hotchk155/oneDpong/docs/oneDpong.png

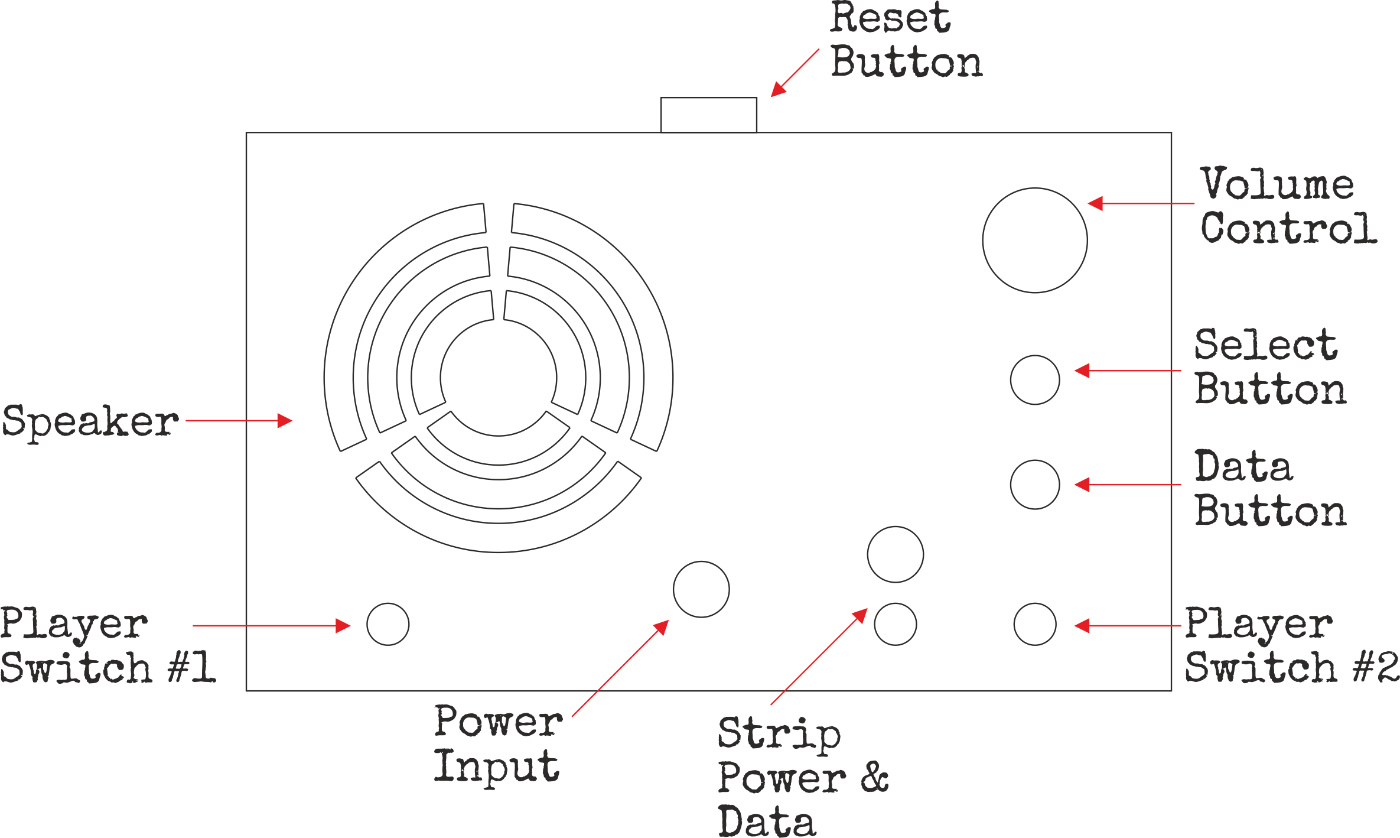
docs/oneDpong.png
