hotchk155/oneDpong/oneDpong.brd

## EAGLE design oneDpong.brd (2025-04-09)

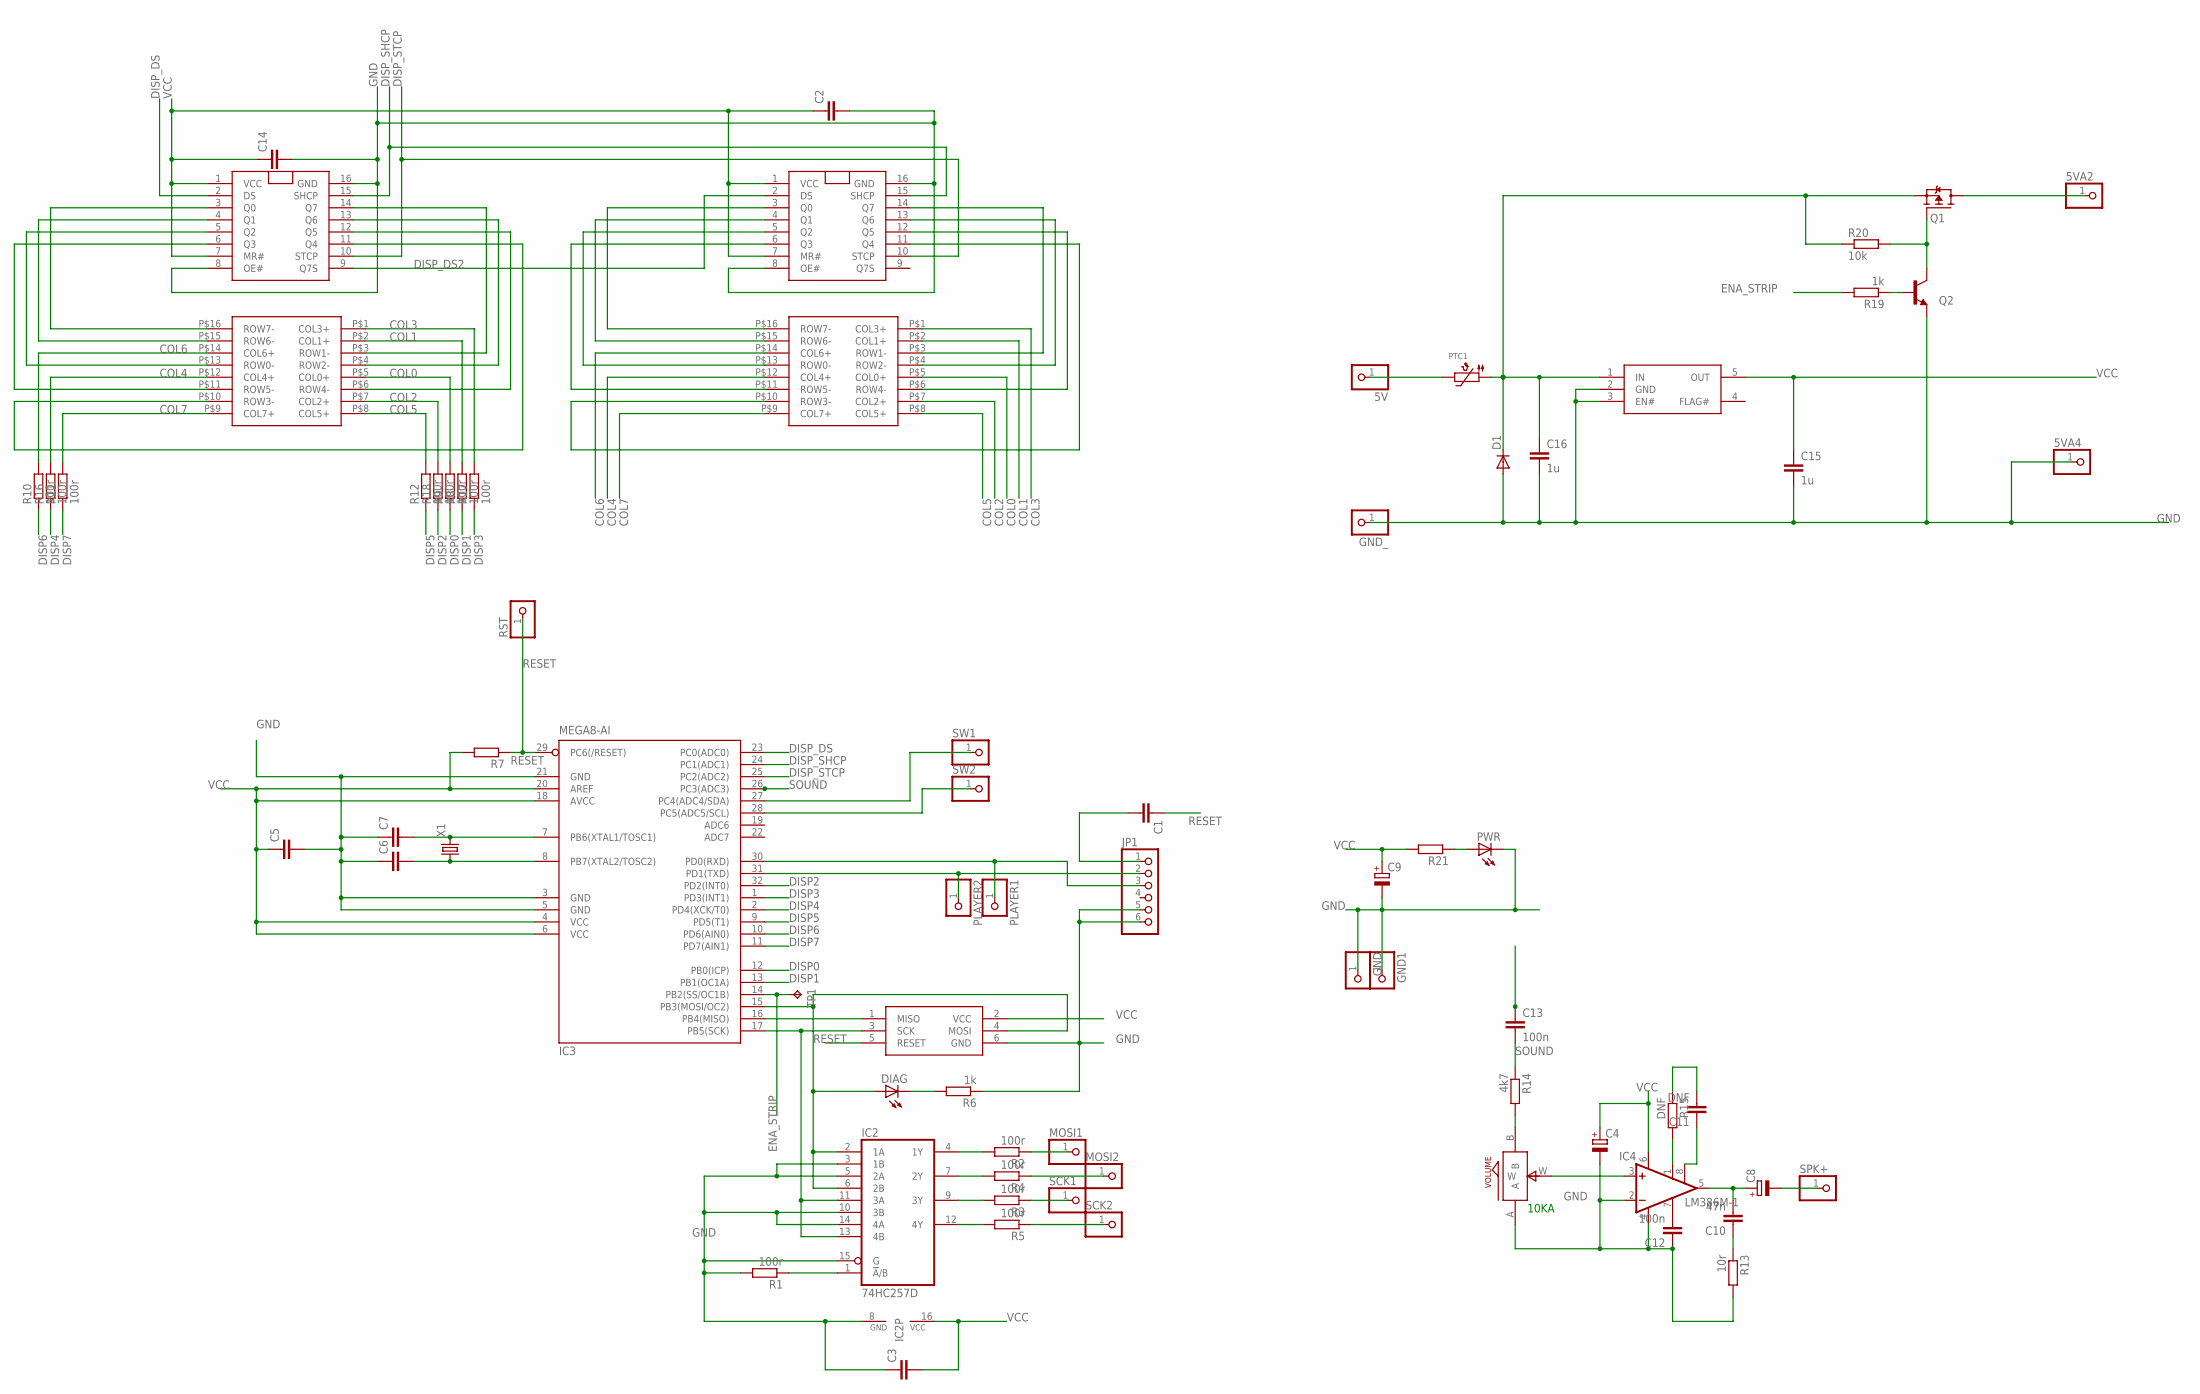
[picture p2: schematic oneDpong.sch]

Parts:
5V, 5VA2, 5VA4: PINHD-1X1; 1X01
C1, C2, C3, C5, C6, C7, C14: C-EUC0805; C0805
C4, C8, C9: CPOL-EUE2.5-6; E2,5-6
C10: 47n; C0805
C11: DNF; C0805
C12, C13: 100n; C0805
C15, C16: 1u; C0805
D1: DIODE-SMC; SMC
DIAG: LED3MM
GND, GND1: PINHD-1X1; 1X01
GND_: PINHD-1X1; 1X01
IC1, IC5: NPIC6C596; SO16
IC2: 74HC257D; SO16
IC3: MEGA8-AI; TQFP32-08
IC4: LM386M-1; SO08
IC6: NCP361SNT1G; SOT23-5
ICSP: TAG_CONN_AVR; TC2030-MCP-NL
JP1: PINHD-1X6; 1X06
MOSI1, MOSI2: PINHD-1X1; 1X01
PLAYER1, PLAYER2: PINHD-1X1; 1X01
PTC1: PTC1812
PWR: LED3MM
Q1: SPD30P06PTO252; TO252
Q2: MMBT3904LT1-NPN-SOT23-BEC; SOT23-BEC
R1, R2, R3, R4, R5, R8, R9, R10, R11, R12, R16, R17, R18: 100r; R0805
R6, R19: 1k; R0805
R7, R21: R-EU_R0805; R0805
R13: 10r; R0805
R14: 4k7; R0805
R15: DNF; R0805
R20: 10k; R0805
RST: PINHD-1X1; 1X01
SCK1, SCK2: PINHD-1X1; 1X01
SPK+: PINHD-1X1; 1X01
SW1, SW2: PINHD-1X1; 1X01
TP1: TPB1,27; B1,27
U$1, U$2: LARGE8X8
VOLUME: ALPS_POT_SMALL; SMALL_ALPS_POT
X1: CRYSTALHC49U-V; HC49U-V

Connections:
COL0: R9.2, U$1.P$5 (COL0+), U$2.P$5 (COL0+)
COL1: R8.2, U$1.P$2 (COL1+), U$2.P$2 (COL1+)
COL2: R18.2, U$1.P$7 (COL2+), U$2.P$7 (COL2+)
COL3: R17.2, U$1.P$1 (COL3+), U$2.P$1 (COL3+)
COL4: R16.2, U$1.P$12 (COL4+), U$2.P$12 (COL4+)
COL5: R12.2, U$1.P$8 (COL5+), U$2.P$8 (COL5+)
COL6: R10.2, U$1.P$14 (COL6+), U$2.P$14 (COL6+)
COL7: R11.2, U$1.P$9 (COL7+), U$2.P$9 (COL7+)
DISP0: IC3.12 (PB0(ICP)), R9.1
DISP1: IC3.13 (PB1(OC1A)), R8.1
DISP2: IC3.32 (PD2(INT0)), R18.1
DISP3: IC3.1 (PD3(INT1)), R17.1
DISP4: IC3.2 (PD4(XCK/T0)), R16.1
DISP5: IC3.9 (PD5(T1)), R12.1
DISP6: IC3.10 (PD6(AIN0)), R10.1
DISP7: IC3.11 (PD7(AIN1)), R11.1
DISP_DS: IC3.23 (PC0(ADC0)), IC5.2 (DS)
DISP_DS2: IC1.2 (DS), IC5.9 (Q7S)
DISP_SHCP: IC1.15 (SHCP), IC3.24 (PC1(ADC1)), IC5.15 (SHCP)
DISP_STCP: IC1.10 (STCP), IC3.25 (PC2(ADC2)), IC5.10 (STCP)
ENA_STRIP: IC3.14 (PB2(SS/OC1B)), R19.2, TP1.TP
GND: 5VA4.1, C2.2, C3.1, C4.-, C5.2, C6.1, C7.1, C9.-, C12.1, C14.2, C15.2, C16.2, D1.A, GND.1, GND1.1, GND_.1, IC1.8 (OE#), IC1.16 (GND), IC2.3 (1B), IC2.5 (2A), IC2.8 (GND), IC2.10 (3B), IC2.14 (4A), IC2.15 (G), IC3.3 (GND), IC3.5 (GND), IC3.21 (GND), IC4.2 (-IN), IC4.4 (GND), IC5.8 (OE#), IC5.16 (GND), IC6.2 (GND), IC6.3 (EN#), ICSP.6 (GND), JP1.5, JP1.6, PWR.K (C), Q2.E, R1.2, R6.1, R13.2, VOLUME.A
MISO: IC3.16 (PB4(MISO)), ICSP.1 (MISO)
MOSI2: MOSI2.1, R4.1
unnamed: IC3.30 (PD0(RXD)), JP1.3, PLAYER1.1
unnamed: IC2.1 (!A!/B), R1.1
unnamed: C7.2, IC3.7 (PB6(XTAL1/TOSC1)), X1.2
unnamed: C6.2, IC3.8 (PB7(XTAL2/TOSC2)), X1.1
unnamed: IC2.4 (1Y), R2.2
unnamed: IC2.7 (2Y), R4.2
unnamed: IC2.11 (3A), IC2.13 (4B), IC3.17 (PB5(SCK)), ICSP.3 (SCK)
unnamed: C10.1, R13.1
unnamed: C1.2, JP1.1
unnamed: IC2.9 (3Y), R3.2
unnamed: IC2.12 (4Y), R5.2
unnamed: MOSI1.1, R2.1
unnamed: 5VA2.1, Q1.3 (D)
unnamed: IC3.31 (PD1(TXD)), JP1.2, PLAYER2.1
unnamed: R5.1, SCK2.1
unnamed: R14.2, VOLUME.B
unnamed: IC4.3 (+IN), VOLUME.W
unnamed: IC3.28 (PC5(ADC5/SCL)), SW2.1
unnamed: C8.+, C10.2, IC4.5 (OUT)
unnamed: C8.-, SPK+.1
unnamed: C12.2, IC4.7 (BYPASS)
unnamed: IC4.1 (GAIN), R15.2
unnamed: C11.2, R15.1
unnamed: C11.1, IC4.8 (GAIN)
unnamed: C13.2, R14.1
unnamed: PWR.A, R21.1
unnamed: DIAG.K (C), R6.2
unnamed: 5V.1, PTC1.P$2 (2)
unnamed: Q1.1 (G), Q2.C, R20.2
unnamed: Q2.B, R19.1
PMOSI: DIAG.A, IC2.2 (1A), IC2.6 (2B), IC3.15 (PB3(MOSI/OC2)), ICSP.4 (MOSI)
Q0A: IC5.3 (Q0), U$1.P$16 (ROW7-)
Q0A1: IC1.3 (Q0), U$2.P$16 (ROW7-)
Q1A: IC5.4 (Q1), U$1.P$15 (ROW6-)
Q1A1: IC1.4 (Q1), U$2.P$15 (ROW6-)
Q2A: IC5.5 (Q2), U$1.P$13 (ROW0-)
Q2A1: IC1.5 (Q2), U$2.P$13 (ROW0-)
Q3A: IC5.6 (Q3), U$1.P$11 (ROW5-)
Q3A1: IC1.6 (Q3), U$2.P$11 (ROW5-)
Q4A: IC5.11 (Q4), U$1.P$10 (ROW3-)
Q4A1: IC1.11 (Q4), U$2.P$10 (ROW3-)
Q5A: IC5.12 (Q5), U$1.P$6 (ROW4-)
Q5A1: IC1.12 (Q5), U$2.P$6 (ROW4-)
Q6A: IC5.13 (Q6), U$1.P$4 (ROW2-)
Q6A1: IC1.13 (Q6), U$2.P$4 (ROW2-)
Q7A: IC5.14 (Q7), U$1.P$3 (ROW1-)
Q7A1: IC1.14 (Q7), U$2.P$3 (ROW1-)
RESET: C1.1, IC3.29 (PC6(/RESET)), ICSP.5 (RESET), R7.1, RST.1
SCK1: R3.1, SCK1.1
SOUND: C13.1, IC3.26 (PC3(ADC3))
SW1: IC3.27 (PC4(ADC4/SDA)), SW1.1
VCC: C2.1, C3.2, C4.+, C5.1, C9.+, C14.1, C15.1, IC1.1 (VCC), IC1.7 (MR#), IC2.16 (VCC), IC3.4 (VCC), IC3.6 (VCC), IC3.18 (AVCC), IC3.20 (AREF), IC4.6 (VS), IC5.1 (VCC), IC5.7 (MR#), IC6.5 (OUT), ICSP.2 (VCC), R7.2, R21.2
VIN: C16.1, D1.C, IC6.1 (IN), PTC1.P$1 (1), Q1.2 (S), R20.1

Notes on the sheet:
10KA

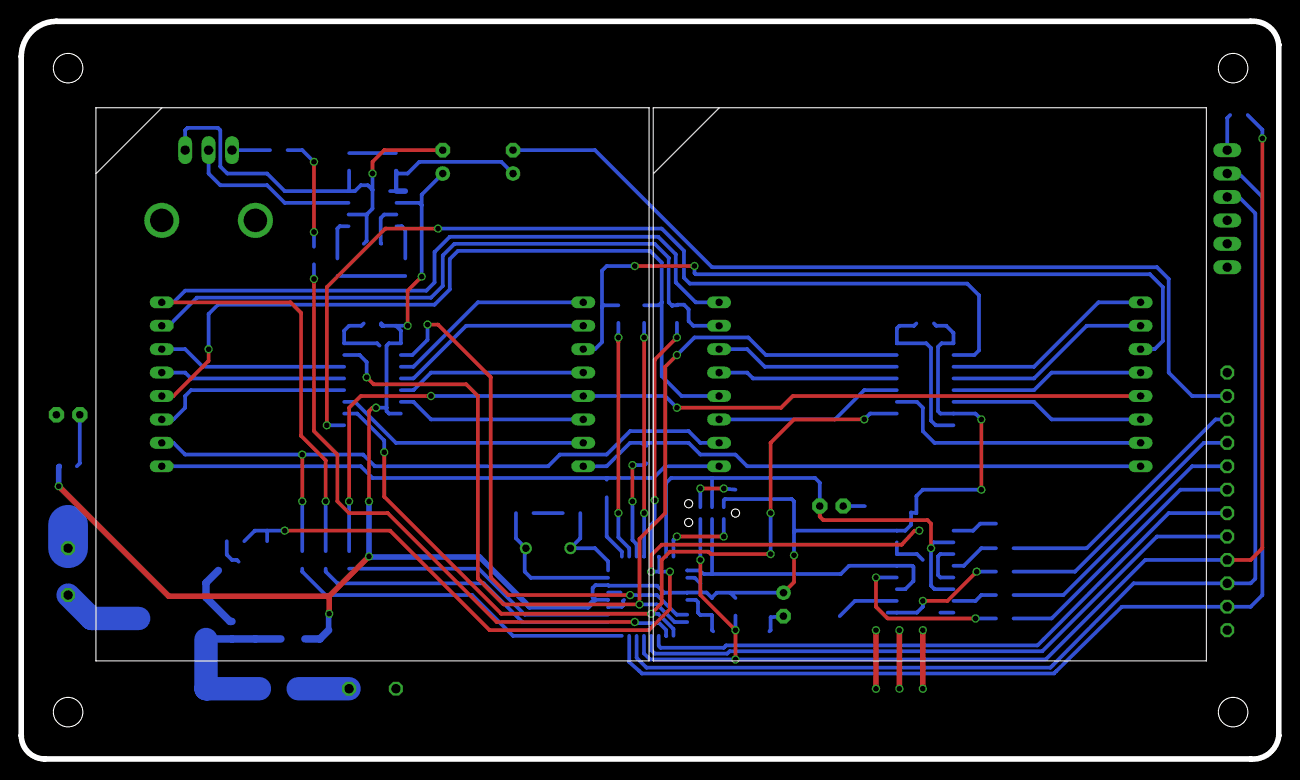
[picture p3: board oneDpong.brd from above]

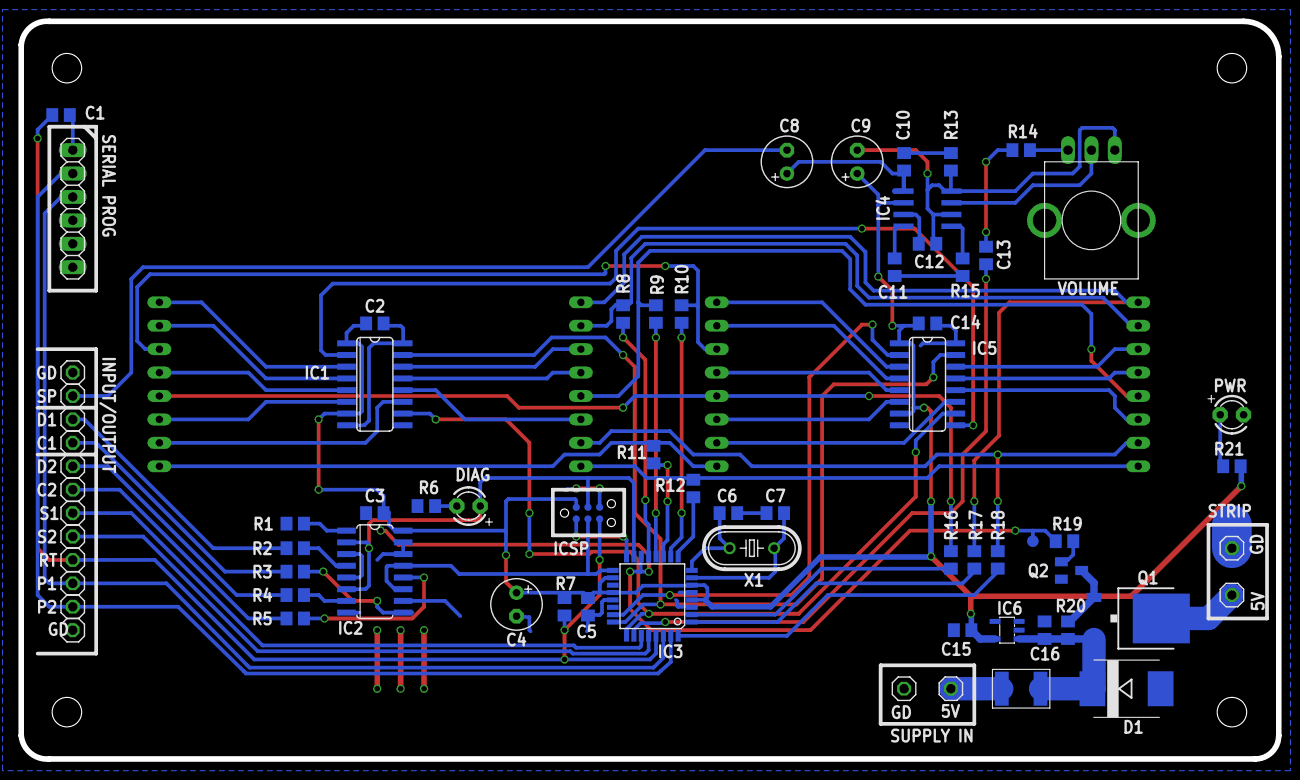
[picture p4: board oneDpong.brd from below]

Board: 2 copper layers, 136.4 x 80.0 mm, 72 parts (70 on the bottom side), 77 nets.
