hotchk155/oneDpong/strandtest/strandtest.ino

// Simple strand test for Adafruit Dot Star RGB LED strip.
// This is a basic diagnostic tool, NOT a graphics demo...helps confirm
// correct wiring and tests each pixel's ability to display red, green
// and blue and to forward data down the line.  By limiting the number
// and color of LEDs, it's reasonably safe to power a couple meters off
// the Arduino's 5V pin.  DON'T try that with other code!

#include <Adafruit_DotStar.h>
// Because conditional #includes don't work w/Arduino sketches...
#include <SPI.h>         // COMMENT OUT THIS LINE FOR GEMMA OR TRINKET
//#include <avr/power.h> // ENABLE THIS LINE FOR GEMMA OR TRINKET

#define NUMPIXELS 300 // Number of LEDs in strip

// Here's how to control the LEDs from any two pins:
#define DATAPIN    11
#define CLOCKPIN   13
#define SELECTPIN   10
Adafruit_DotStar strip = Adafruit_DotStar(NUMPIXELS, DATAPIN, CLOCKPIN);

// Hardware SPI is a little faster, but must be wired to specific pins
// (Arduino Uno = pin 11 for data, 13 for clock, other boards are different).
//Adafruit_DotStar strip = Adafruit_DotStar(NUMPIXELS);

void setup() {

#if defined(__AVR_ATtiny85__) && (F_CPU == 16000000L)
  clock_prescale_set(clock_div_1); // Enable 16 MHz on Trinket
#endif

  pinMode(SELECTPIN, OUTPUT);
  digitalWrite(SELECTPIN, LOW);
  strip.begin(); // Initialize pins for output
  strip.show();  // Turn all LEDs off ASAP
}

// Runs 10 LEDs at a time along strip, cycling through red, green and blue.
// This requires about 200 mA for all the 'on' pixels + 1 mA per 'off' pixel.

int      head  = 0, tail = -10; // Index of first 'on' and 'off' pixels
uint32_t color = 0xFF0000;      // 'On' color (starts red)

void loop() {

  strip.setPixelColor(head, color); // 'On' pixel at head
  strip.setPixelColor(tail, 0);     // 'Off' pixel at tail
  strip.show();                     // Refresh strip
  //delay(2);                        // Pause 20 milliseconds (~50 FPS)

  if(++head >= NUMPIXELS) {         // Increment head index.  Off end of strip?
    head = 0;                       //  Yes, reset head index to start
    if((color >>= 8) == 0)          //  Next color (R->G->B) ... past blue now?
      color = 0xFF0000;             //   Yes, reset to red
  }
  if(++tail >= NUMPIXELS) tail = 0; // Increment, reset tail index
}
