hotchk155/oneDpong/(commit log)

2015-05-29 more tweaks
    [oneDpong.brd]
2015-05-29 pcb ready
    [oneDpong.brd, oneDpong.sch]
2015-08-29 add overvoltage protect, refactor
    [oneDpong.brd, oneDpong.sch]
2017-07-17 tidy up values
    [charset.ods, oneDpong.brd, oneDpong.sch]
2019-10-09 poss V3
    [oneDpong.brd, oneDpong.sch]
2019-10-09 V3 BOARD
    [oneDpong.brd, oneDpong.sch]
