hotchk155/oneDpong/(notices)

Notices in the files:
oneDpong.brd:
creativecommons.org/licenses/by-nc-sa/4.0
parts and their libraries:
jasons_stuff: ©2009 ROFA.cz - modified and updated by Robert Darlington ‹rdarlington@gmail.com›
